AcheronProject/Anubis/kicad_files/anubis.kicad_sch

## KiCad design kicad_files/anubis.kicad_sch (2022-05-24)

Schematic: anubis.kicad_sch

Parts:
C1, C3, C7, C8, C9, C15, C16: 100n; C_0402_1005Metric; Manufacturer Part Number CL05B104KB54PNC
C2: 10u; C_0402_1005Metric; Manufacturer Part Number CL05A106MQ5NUNC
C4, C5: 1u; C_0805_2012Metric; Manufacturer Part Number 0805B105K500NT
C6, C14: 10n; C_0402_1005Metric; Manufacturer Part Number CL05B103KB5NNNC
C10: 10u; CP_EIA-3216-10_Kemet-I_Pad1.58x1.35mm_HandSolder; Manufacturer Part Number TAJA106K016RNJ
C11, C12: 15p; C_0402_1005Metric; Manufacturer Part Number 0402CG150J500NT
C13, C17: 4.7u; C_0402_1005Metric; Manufacturer Part Number CL05A475MP5NRNC
D1, D3, D4, D5, D6, D7, D8, D9, D10, D11, D12, D13, D14, D15, D16, D17, D18, D19, D20, D21, D22, D23, D24, D25, D26, D27, D28, D29, D30, D31, D32, D33, D34, D35, D36, D37, D38, D39, D40, D41, D42, D43, D44, D45, D46, D47, D48, D49, D50, D51, D52, D53, D54, D55, D56, D57, D58, D59, D60, D61, D62, D63, D64, D65, D66, D67, D68, D69, D70, D71, D72, D73, D74, D75, D76, D77, D78, D79, D80, D81, D82, D83, D84, D85, D86, D87, D88, D89, D90, D91, D92, D93: 1N4148W; D_SOD-123; Manufacturer Part Number 1N4148W
D2: B5819W-SL; D_SOD-123; Manufacturer Part Number B5819W-SL
GR1: Anubis huge logo; anubis_huge_logo
GR2: Anubis plated letters; anubis_plated_letters_30x4mm
GR3: Anubis label; anubis_label
J1, J2: A1001WR-S-04P; SM04B-SRSS-TB(LF)(SN)_mounting-reliefs; Manufacturer Part Number A1001WR-S-04P
LED1, LED2, LED3, LED4, LED5: LED; LED_THT_2.54mm
Q1: AO3401A; SOT-23; Manufacturer Part Number Alpha & Omega Semicon
Q2: 2N7002; SOT-23; Manufacturer Part Number 2N7002
Q3, Q4, Q5, Q6: DTC123JKAT146; SOT-23; Manufacturer Part Number DTC123JKAT146
R1, R6, R7, R8, R18, R21: 10k; R_0402_1005Metric; Manufacturer Part Number 0402WGF1002TCE
R2: 100; R_0402_1005Metric; Manufacturer Part Number 0402WGF1000TCE
R3: 330k; R_0402_1005Metric; Manufacturer Part Number 0402WGF3303TCE
R4, R9, R14, R15: 100R; R_0402_1005Metric; Manufacturer Part Number 0402WGF1000TCE
R5: 1M; R_0402_1005Metric; Manufacturer Part Number 0402WGF1004TCE
R10, R11, R12, R13: 1k; R_0402_1005Metric; Manufacturer Part Number 0402WGF1001TCE
R16, R17: 0R; R_0805_2012Metric; Manufacturer Part Number 0805W8F0000T5E
R19, R20: 100k; R_0805_2012Metric; Manufacturer Part Number 0805W8F1003T5E
R22, R23: 4.7k; R_0402_1005Metric; Manufacturer Part Number 0402WGF4701TCE
R24: 1.5k; R_0402_1005Metric; Manufacturer Part Number 0402WGF1501TCE
SW1: K2-1187SQ-A4SW-06; Manufacturer Part Number K2-1187SQ-A4SW-06
SW2, SW3, SW4, SW5, SW6, SW7, SW8, SW9, SW10, SW11, SW12, SW13, SW14, SW15, SW16, SW17, SW18, SW19, SW20, SW21, SW22, SW23, SW24, SW25, SW26, SW27, SW28, SW29, SW30, SW31, SW33, SW34, SW35, SW36, SW38, SW39, SW40, SW41, SW42, SW43, SW44, SW45, SW46, SW47, SW48, SW49, SW51, SW52, SW53, SW55, SW56, SW57, SW58, SW59, SW60, SW61, SW62, SW63, SW64, SW65, SW66, SW71, SW72, SW73, SW74, SW75, SW76, SW77, SW78, SW79, SW80, SW81, SW83, SW84, SW95, SW96, SW97, SW99, SW103: MX Switch; MX100
SW32: MX Switch; MX200
SW37, SW50, SW98, SW100, SW102, SW104: MX Switch; MX150
SW54, SW85: MX Switch; MX175
SW67: MX Switch; MX225R
SW68, SW86, SW87, SW88, SW89, SW91, SW92, SW93, SW94: MX Switch; MX125
SW69: MX Switch; MX_ISOEnter
SW70: MX Switch; MX225
SW82: MX Switch; MX275
SW90: MX Switch; MX625R
SW101: MX Switch; MX700R
U1: AT24C256C-SSHL-T; SOIC-8; Manufacturer Part Number AT24C256C-SSHL-T
U2: 2N7002DW; SOT-363_SC-70-6; Manufacturer Part Number 2N7002DW
U3: SGM2007-3.3XN5/TR; SOT-23-5; Manufacturer Part Number SGM2007-3.3XN5/TR
U4: STM32F401RCT6; LQFP-64_10x10mm_P0.5mm; Manufacturer Part Number STM32F401RCT6
X1: ARM JTAG; PinHeader_2x5_P2.54mm_Vertical_Staggered
X2: EXTRA_PINS; PinHeader_2x6_P2.54mm_Vertical
X3: EXTRA_PINS; PinHeader_2x3_P2.54mm_Vertical
Y1: TAXM8M4RFDCET2T; Crystal_SMD_3225-4Pin_3.2x2.5mm; Manufacturer Part Number TAXM8M4RFDCET2T

Connections:
3V3: C1.2, C5.1, C7.2, C8.1, C9.1, C10.1, C13.2, C14.2, C15.2, C16.1, D2.2 (A), R20.1, R22.2, R23.2, R24.2, SW1.1 (A), U1.8 (VCC), U3.5 (OUT), U4.1 (VBAT), U4.13 (VDDA/VREF+), U4.19 (VDD), U4.32 (VDD), U4.48 (VDD), U4.64 (VDD), X1.7, X1.8, X2.11, X3.2
5V: C4.1, D2.1 (K), J1.1, J2.1, Q1.2 (S), R1.2, R19.1, U3.1 (IN), U3.3 (EN), X2.12
BOOT0: C2.1, R3.1, R5.1, R7.2, U4.60 (BOOT0), X1.5
C0: SW2.2, SW19.2, SW37.2, SW54.2, SW68.1, SW70.2, SW86.1, SW87.2, SW98.2, U4.39 (USART6_CK/TIM3_CH3/PC8)
C1: SW3.1, SW20.1, SW38.1, SW55.1, SW71.1, SW88.1, SW99.1, U4.38 (USART6_RX/TIM3_CH2/PC7)
C2: SW4.1, SW21.1, SW39.1, SW56.1, SW72.2, SW89.1, SW100.1, U4.37 (I2S2_MCK/TIM3_CH1/USART6_TX/PC6)
C3: SW5.1, SW22.1, SW40.1, SW57.1, SW73.1, U4.35 (SPI2_MISO/PB14)
C4: SW6.1, SW23.1, SW41.1, SW58.1, SW74.1, U4.33 (PB12)
C5: SW7.1, SW24.1, SW42.1, SW59.1, SW75.1, U4.29 (PB10/TIM2_CH3/SPI2_SCK/I2C2_SCL/I2S2_CK)
C6: SW8.1, SW25.1, SW43.1, SW60.1, SW76.1, SW90.1, SW101.2, U4.26 (PB0/TIM3_CH3)
C7: SW9.1, SW26.1, SW44.1, SW61.1, SW77.1, U4.25 (PC5)
C8: SW10.1, SW27.1, SW45.1, SW62.1, SW78.1, U4.24 (PC4)
C9: SW11.1, SW28.1, SW46.1, SW63.1, SW79.1, U4.23 (PA7/SPI1_MOSI/TIM3_CH2)
C10: SW12.1, SW29.1, SW47.1, SW64.1, SW80.1, SW91.1, U4.22 (PA6/TIM3_CH1/SPI1_MISO)
C11: SW13.1, SW30.1, SW48.1, SW65.1, SW81.1, SW92.1, SW102.1, U4.21 (PA5/TIM2_CH1/SPI1_SCK)
C12: SW14.1, SW31.1, SW49.1, SW66.1, SW82.1, SW85.1, SW93.1, SW103.1, U4.20 (PA4/USART2_CK)
C13: SW15.1, SW32.1, SW36.1, SW50.1, SW67.1, SW69.1, SW83.2, SW94.1, SW104.1, U4.17 (PA3/TIM2_CH4/USART2_RX)
C14: SW16.2, SW33.2, SW51.2, SW95.2, U4.56 (NJTRST/SPI1_MISO/SPI3_MISO/I2C3_SDA/TIM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)
C15: SW17.1, SW34.1, SW52.1, SW84.1, SW96.1, U4.55 (JTDO-SWO/SPI1_SCK/SPI3_SCK/I2C2_SDA/TIM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)
C16: SW18.1, SW35.1, SW53.1, SW97.1, U4.54 (PD2)
CAPS_INDICATOR: Q3.1 (B), U4.40 (TIM3_CH4/I2S_CKIN/PC9)
D+: J2.3, R17.2, R24.1, U4.45 (OTG_FS_DP/USART6_RX/PA12)
D-: J2.2, R16.1, U4.44 (OTG_FS_DM/TIM1_CH4/USART6_TX/PA11)
DR+: J1.3, R17.1
DR-: J1.2, R16.2
E-PA0: U4.14 (PA0/TIM2_CH1/USART2_CTS), X2.5
E-PA9: U4.42 (USART1_TX/TIM1_CH2/PA9), X3.4
E-PB5: U4.57 (SPI1_MOSI/SPI3_MOSI/TIM3_CH2/PB5), X3.6
E-PB8: U4.61 (I2C1_SCL/TIM4_CH3/TIM10_CH1/PB8), X3.5
E-PB9: U4.62 (I2C1_SDA/TIM4_CH4/TIM11_CH1/PB9), X3.3
E-PB13: U4.34 (SPI2_SCK/I2S2_CK/PB13), X2.8
E-PB15: U4.36 (SPI2_MOSI/PB15), X2.10
E-PC0: U4.8 (PC0), X2.3
E-PC2: U4.10 (PC2/SPI2_MISO), X2.9
E-PC3: U4.11 (PC3/SPI2_MOSI), X2.7
E-PC13: U4.2 (PC13), X2.6
E-PC14: U4.3 (PC14/OSC32_IN), X2.4
E-PC15: U4.4 (PC15/OSC32_OUT), X2.2
GND: C1.1, C2.2, C3.2, C4.2, C5.2, C6.1, C7.1, C8.2, C9.2, C10.2, C11.2, C12.2, C13.1, C14.1, C15.1, C16.2, C17.1, J1.4, J1.MP (MountPin), J2.4, J2.MP (MountPin), Q2.2 (S), Q3.2 (E), Q4.2 (E), Q5.2 (E), Q6.2 (E), R5.2, R6.1, R8.2, R18.1, R19.2, R20.2, R21.2, U1.1 (A0), U1.2 (A1), U1.3 (A2), U1.4 (GND), U1.7 (WP), U2.1 (S), U2.4 (S), U3.2 (GND), U4.12 (VSSA/VREF-), U4.18 (VSS), U4.31 (VSS), U4.47 (VSS), U4.63 (VSS), X1.3, X1.4, X1.10, X2.1, X3.1, Y1.2, Y1.4
INDICATOR1: Q4.1 (B), U4.51 (SPI3_SCK/I2S3_CK/PC10)
INDICATOR2: Q5.1 (B), U4.52 (SPI3_MISO/PC11)
INDICATOR3: Q6.1 (B), U4.53 (SPI3_MOSI/PC12)
LED_PWM: R4.2, U4.43 (USART1_RX/TIM1_CH3/PA10)
NRST: C3.1, R14.2, U4.7 (NRST), X1.9
unnamed: C6.2, U3.4 (BP/FB)
unnamed: C17.2, U4.30 (VCAP1)
unnamed: D1.1 (K), R3.2
unnamed: D1.2 (A), R15.2, SW1.2 (B)
unnamed: D3.2 (A), SW2.1
unnamed: D4.2 (A), SW3.2
unnamed: D5.2 (A), SW4.2
unnamed: D6.2 (A), SW5.2
unnamed: D7.2 (A), SW6.2
unnamed: D8.2 (A), SW7.2
unnamed: D9.2 (A), SW8.2
unnamed: D10.2 (A), SW9.2
unnamed: D11.2 (A), SW10.2
unnamed: D12.2 (A), SW11.2
unnamed: D13.2 (A), SW12.2
unnamed: D14.2 (A), SW13.2
unnamed: D15.2 (A), SW14.2
unnamed: D16.2 (A), SW15.2
unnamed: D17.2 (A), SW16.1
unnamed: D18.2 (A), SW17.2
unnamed: D19.2 (A), SW18.2
unnamed: D20.2 (A), SW19.1
unnamed: D21.2 (A), SW20.2
unnamed: D22.2 (A), SW21.2
unnamed: D23.2 (A), SW22.2
unnamed: D24.2 (A), SW23.2
unnamed: D25.2 (A), SW24.2
unnamed: D26.2 (A), SW25.2
unnamed: D27.2 (A), SW26.2
unnamed: D28.2 (A), SW27.2
unnamed: D29.2 (A), SW28.2
unnamed: D30.2 (A), SW29.2
unnamed: D31.2 (A), SW30.2
unnamed: D32.2 (A), SW31.2
unnamed: D33.2 (A), SW32.2, SW36.2
unnamed: D34.2 (A), SW33.1
unnamed: D35.2 (A), SW34.2
unnamed: D36.2 (A), SW35.2
unnamed: D37.2 (A), SW37.1
unnamed: D38.2 (A), SW38.2
unnamed: D39.2 (A), SW39.2
unnamed: D40.2 (A), SW40.2
unnamed: D41.2 (A), SW41.2
unnamed: D42.2 (A), SW42.2
unnamed: D43.2 (A), SW43.2
unnamed: D44.2 (A), SW44.2
unnamed: D45.2 (A), SW45.2
unnamed: D46.2 (A), SW46.2
unnamed: D47.2 (A), SW47.2
unnamed: D48.2 (A), SW48.2
unnamed: D49.2 (A), SW49.2
unnamed: D50.2 (A), SW50.2
unnamed: D51.2 (A), SW51.1
unnamed: D52.2 (A), SW52.2
unnamed: D53.2 (A), SW53.2
unnamed: D54.2 (A), SW54.1, SW68.2
unnamed: D55.2 (A), SW55.2
unnamed: D56.2 (A), SW56.2
unnamed: D57.2 (A), SW57.2
unnamed: D58.2 (A), SW58.2
unnamed: D59.2 (A), SW59.2
unnamed: D60.2 (A), SW60.2
unnamed: D61.2 (A), SW61.2
unnamed: D62.2 (A), SW62.2
unnamed: D63.2 (A), SW63.2
unnamed: D64.2 (A), SW64.2
unnamed: D65.2 (A), SW65.2
unnamed: D66.2 (A), SW66.2
unnamed: D67.2 (A), SW67.2, SW69.2
unnamed: D68.2 (A), SW70.1, SW86.2
unnamed: D69.2 (A), SW71.2
unnamed: D70.2 (A), SW72.1
unnamed: D71.2 (A), SW73.2
unnamed: D72.2 (A), SW74.2
unnamed: D73.2 (A), SW75.2
unnamed: D74.2 (A), SW76.2
unnamed: D75.2 (A), SW77.2
unnamed: D76.2 (A), SW78.2
unnamed: D77.2 (A), SW79.2
unnamed: D78.2 (A), SW80.2
unnamed: D79.2 (A), SW81.2
unnamed: D80.2 (A), SW82.2, SW85.2
unnamed: D81.2 (A), SW83.1
unnamed: D82.2 (A), SW84.2
unnamed: D83.2 (A), SW87.1, SW98.1
unnamed: D84.2 (A), SW88.2, SW99.2
unnamed: D85.2 (A), SW89.2, SW100.2
unnamed: D86.2 (A), SW90.2, SW101.1
unnamed: D87.2 (A), SW91.2
unnamed: D88.2 (A), SW92.2, SW102.2
unnamed: D89.2 (A), SW93.2, SW103.2
unnamed: D90.2 (A), SW94.2, SW104.2
unnamed: D91.2 (A), SW95.1
unnamed: D92.2 (A), SW96.2
unnamed: D93.2 (A), SW97.2
unnamed: LED1.A, LED2.A, LED3.A, LED4.A, LED5.A, Q1.3 (D), R8.1
unnamed: LED1.K, LED2.K, R13.1
unnamed: LED3.K, R10.1
unnamed: LED4.K, R11.1
unnamed: LED5.K, R12.1
unnamed: Q1.1 (G), R2.2
unnamed: Q2.1 (G), R4.1, R6.2
unnamed: Q2.3 (D), R1.1, R2.1
unnamed: Q3.3 (C), R13.2
unnamed: Q4.3 (C), R10.2
unnamed: Q5.3 (C), R11.2
unnamed: Q6.3 (C), R12.2
unnamed: R7.1, U2.3 (D)
unnamed: R9.1, U2.5 (G)
unnamed: R9.2, R14.1, U2.6 (D)
unnamed: R15.1, R18.2, U2.2 (G)
PB2/BOOT1: R21.1, U4.28 (PB2), X1.6
R0: D3.1 (K), D4.1 (K), D5.1 (K), D6.1 (K), D7.1 (K), D8.1 (K), D9.1 (K), D10.1 (K), D11.1 (K), D12.1 (K), D13.1 (K), D14.1 (K), D15.1 (K), D16.1 (K), D17.1 (K), D18.1 (K), D19.1 (K), U4.41 (USART1_CK/TIM1_CH1/PA8)
R1: D20.1 (K), D21.1 (K), D22.1 (K), D23.1 (K), D24.1 (K), D25.1 (K), D26.1 (K), D27.1 (K), D28.1 (K), D29.1 (K), D30.1 (K), D31.1 (K), D32.1 (K), D33.1 (K), D34.1 (K), D35.1 (K), D36.1 (K), U4.50 (JTDI/TIM2_CH1/PA14)
R2: D37.1 (K), D38.1 (K), D39.1 (K), D40.1 (K), D41.1 (K), D42.1 (K), D43.1 (K), D44.1 (K), D45.1 (K), D46.1 (K), D47.1 (K), D48.1 (K), D49.1 (K), D50.1 (K), D51.1 (K), D52.1 (K), D53.1 (K), U4.27 (PB1/TIM3_CH4)
R3: D54.1 (K), D55.1 (K), D56.1 (K), D57.1 (K), D58.1 (K), D59.1 (K), D60.1 (K), D61.1 (K), D62.1 (K), D63.1 (K), D64.1 (K), D65.1 (K), D66.1 (K), D67.1 (K), U4.16 (PA2/TIM2_CH3/USART2_TX)
R4: D68.1 (K), D69.1 (K), D70.1 (K), D71.1 (K), D72.1 (K), D73.1 (K), D74.1 (K), D75.1 (K), D76.1 (K), D77.1 (K), D78.1 (K), D79.1 (K), D80.1 (K), D81.1 (K), D82.1 (K), U4.15 (PA1/TIM2_CH2/USART2_RTS)
R5: D83.1 (K), D84.1 (K), D85.1 (K), D86.1 (K), D87.1 (K), D88.1 (K), D89.1 (K), D90.1 (K), D91.1 (K), D92.1 (K), D93.1 (K), U4.9 (PC1)
SCL: R23.1, U1.6 (SCL), U4.58 (I2C1_SCL/USART1_TX/TIM4_CH1/PB6)
SDA: R22.1, U1.5 (SDA), U4.59 (I2C1_SDA/USART1_RX/TIM4_CH2/PB7)
SWCLK: U4.49 (JTCK-SWCLK/PA14), X1.2
SWDIO: U4.46 (JTMS-SWDIO/PA13), X1.1
XTAL_IN: C11.1, U4.5 (PH0/OSC_IN), Y1.3
XTAL_OUT: C12.1, U4.6 (PH1/OSC_OUT), Y1.1

Notes on the sheet:
EEPROM
WARNING: be sure to select the JST needed with the isolating resistors!
GRAPHICS
HARD RESET
ANDROMEDA
SPOOKY PIN
DB CONNS
(*) "Spooky pins": on STM32F4x1, pins A9 and B2 cannot be used for switch matrix: - A9 is meant to be used as a VBUS sensing. It has a undocumented internal pulldown resistor; - B2 is used as BOOT1 during bootup, so it needs an external pulldown for successful bootup
(**) PA9 jumper: a solderable jumper used to tie PA9 to VBUS. It is disconnected by default, hence PA9 is left floating
SWITCH MATRIX
3V3
WT80
MCU
INDICATORS
