AcheronProject/Anubis/(commit log)

2022-05-18 Remove F13, add screw points, move JST
    - F13 layout removed: the old JST position was incompatible with F13 layout because it overlapped with the F1 key
    - Screw points: added one for Idol and Ecliptica
    - JST moved to the original WT80 position
    [anubis.kicad_sch]
2022-05-18 Some routing
    [anubis.kicad_sch]
2022-05-20 Update submodules, more routing
    [anubis.kicad_sch]
2022-05-21 Finish routing and DRC, prepare for release
    [anubis.kicad_sch, spacers.kicad_pcb]
2022-05-21 Link LED_PWM pin to A10
    [anubis.kicad_sch]
2022-05-21 Add label
    [anubis.kicad_sch]
2022-05-21 Edit component metadata
    [anubis.kicad_sch]
2022-05-24 Remove unnecessaru screw cutouts
2022-05-24 Metadata, QoL
    [anubis.kicad_sch]
2022-05-24 Remove unintended unconnected track ends
2023-01-31 Remove old spacers
    [spacers.kicad_pcb]
